Whirligig231/myrmidon/Docs/M_Machine_Spec.xlsx

CONTROL FLOW
Instruction |  |  |  | Assembly | Description | Notes
00 | 00 | 00 | 00 | nop | Nop
01 | 00 | xx | xx | end | End if / while / routine | The assembler marks a relative jump address. You must return before the end instruction
02 | xx | yy | yy | if xx | If register xx is nonzero | The assembler marks a relative jump address
03 | xx | yy | yy | while xx | While register xx is nonzero | The assembler marks a relative jump address
04 | 00 | xx | xx | else | Else | The assembler marks a relative jump address
05 | xx | 00 | 00 | switch xx | Jump a number of instructions ahead equal to register xx
06 | xx | yy | yy | gz xx NAME | Goto if register xx is zero | The label will be replaced by a relative jump in the assembler
07 | xx | yy | yy | gnz xx NAME | Goto if register xx is nonzero | The label will be replaced by a relative jump in the assembler
08 | xx | yy | yy | def NAME | Define routine (but do not run it) | The assembler marks a relative jump address
09 | xx | 00 | 00 | call NAME | Call routine and return here after
0a | 00 | xx | xx | goto NAME | Go to label NAME | The label will be replaced by a relative jump in the assembler
0b | 00 | xx | xx | break | Break while loop | The assembler marks a relative jump address
0c | 00 | xx | xx | continue | Continue while loop | The assembler marks a relative jump address
0d | 00 | 00 | 00 | return | Return from routine
0e | 00 | 00 | 00 | reset | Restart the system
0f | xx | 00 | 00 | print xx | Print the value of register xx, unsigned, over the serial connection | For debug use only
ARITHMETIC
Instruction |  |  |  | Assembly | Description | Notes
10 | xx | yy | zz | + xx yy zz | Set register xx to the sum of registers yy and zz
11 | xx | yy | zz | - xx yy zz | Set register xx to the difference of registers yy and zz | For negation, use - xx 0 yy
12 | xx | yy | zz | * xx yy zz | Set register xx to the product of registers yy and zz | Yes, this works both signed and unsigned, thanks to the magic of the ring Z/65536Z. Trust me, I have a math degree
13 | xx | yy | zz | / xx yy zz | Set register xx to the unsigned quotient of registers yy and zz | Division by zero is undefined behavior (I'm too lazy to implement exceptions)
14 | xx | yy | zz | s/ xx yy zz | Set register xx to the signed quotient of registers yy and zz
15 | xx | yy | zz | % xx yy zz | Set register xx to the unsigned modulus of registers yy and zz
16 | xx | yy | zz | s% xx yy zz | Set register xx to the signed modulus of registers yy and zz
17 | xx | yy | zz | frac xx yy zz | Set register xx to the fractional part of the unsigned quotient yy / zz | This sets xx to the first four digits of yy / zz after the decimal point in base 16. In other words, xx / 65536 ~= yy / zz
18 | xx | yy | zz | sfrac xx yy zz | Set register xx to the fractional part of the signed quotient yy / zz | The fractional part is computed using floor(), so e.g. the fractional part of -1.4 is +0.6. Output is unsigned
19 | xx | yy | zz | == xx yy zz | Set register xx to 1 if registers yy and zz are equal and 0 otherwise | For boolean NOT, use == xx yy 0
1a | xx | yy | zz | != xx yy zz | Set register xx to 1 if registers yy and zz are unequal and 0 otherwise
1b | xx | yy | zz | < xx yy zz | Set register xx to 1 if register yy is less than zz, unsigned, and 0 otherwise | For >, use < xx zz yy
1c | xx | yy | zz | s< xx yy zz | Set register xx to 1 if register yy is less than zz, signed, and 0 otherwise
1d | xx | yy | zz | <= xx yy zz | Set register xx to 1 if register yy is less than or equal to zz, signed, and 0 otherwise | For >=, use <= xx zz yy
1e | xx | yy | zz | s<= xx yy zz | Set register xx to 1 if register yy is less than or equal to zz, signed, and 0 otherwise
1f | xx | yy | zz | & xx yy zz | Set register xx to the bitwise AND of registers yy and zz
20 | xx | yy | zz | && xx yy zz | Set register xx to the boolean AND of registers yy and zz
21 | xx | yy | zz | | xx yy zz | Set register xx to the bitwise OR of registers yy and zz | For ||, using | will be sufficient for conditionals. If you really need ||, you can use != zz zz 0 afterwards
22 | xx | yy | zz | ^ xx yy zz | Set register xx to the bitwise XOR of registers yy and zz | For ~, use ^ xx yy -1
23 | xx | yy | zz | << xx yy zz | Set register xx to register yy shifted left register zz times | Here zz is unsigned
24 | xx | yy | zz | >> xx yy zz | Set register xx to register yy shifted right register zz times | Here zz is unsigned
25 | xx | yy | zz | ? xx yy zz | Set register xx to register zz, only if yy is zero | Pay attention to the order of operators here. This can be used with = to simulate the behavior of the ternary operator ?:
26 | xx | yy | zz | absgn xx yy zz | Set register xx to the absolute value of register zz and yy to its signum
27 | xx | yy | zz | sqrt xx yy zz | Set register xx to the integer part of the square root of register zz and yy to the fractional part | Fractional part format is as in frac; zz is unsigned
28 | xx | yy | zz | red xx yy zz | Set the register xx to register yy with the red part changed to register zz | Here zz should be from 0 to 255
29 | xx | yy | zz | green xx yy zz | Set the register xx to register yy with the green part changed to register zz | Note that the green part has double the resolution, 6 bits instead of 5; the scale on zz is still 0 to 255
2a | xx | yy | zz | blue xx yy zz | Set the register xx to register yy with the blue part changed to register zz | Here zz should be from 0 to 255
2b | xx | yy | zz | +c xx yy zz | Set register xx to the carry when registers yy and zz are added, unsigned | These carry operations are used to implement Q16.16 or Q32.0 arithmetic
2c | xx | yy | zz | -c xx yy zz | Set register xx to the carry when registers yy and zz are subtracted, unsigned | See above
2d | xx | yy | zz | *c xx yy zz | Set register xx to the carry when registers yy and zz are mutliplied, unsigned | See above
2e | xx | yy | zz | conc xx yy zz | Set register xx to the low byte of register yy times 256 plus the low byte of register zz
2f | xx | yy | 00 | high xx yy | Set register xx to the high byte of register yy | For the low byte, use conc xx 0 yy
LOADING AND STORING
Instruction |  |  |  | Assembly | Description | Notes
30 | xx | yy | 00 | = xx yy | Set register xx to register yy (copy yy to xx)
31 | xx | yy | yy | = xx yyyy | Set register xx to immediate yyyy
32 | xx | yy | 00 | load xx yy | Load word at pointer yy into register xx
33 | xx | yy | yy | load xx yyyy | Load word at address yyyy into register xx
34 | xx | yy | 00 | store xx yy | Store register xx into word at pointer yy | One of the few commands where the input comes before the output
35 | xx | yy | yy | store xx yyyy | Store register xx into word at address yyyy | One of the few commands where the input comes before the output
36 | 00 | xx | 00 | window xx | Set the "window" (upper half of register space) to start at pointer xx
37 | 00 | xx | xx | window xxxx | Set the "window" (upper half of register space) to start at address xxxx
38 | 00 | xx | 00 | skip xx | Clear the stack and skip to code at pointer xx
39 | 00 | xx | xx | skip xxxx | Clear the stack and skip to code at address xxxx
3a | 00 | xx | 00 | skim xx | Read all def instructions in page starting at pointer xx | This does not use the standard instruction pointer, so execution will return immediately. Control flow is ignored. Reading starts at *xx and continues to the end of the page
3b | 00 | xx | xx | skim xxxx | Read all def instructions in page starting at address xxxx | See above
40 | xx | yy | 00 | read xx yy | Read a page of ROM indexed by register xx and overwrite the page at pointer yy | One of the few commands where the input comes before the output
41 | xx | yy | yy | read xx yyyy | Read a page of ROM indexed by register xx and overwrite the page at address yyyy | One of the few commands where the input comes before the output
42 | xx | yy | 00 | write xx yy | Write the page at pointer yy into the ROM page indexed by register xx | This will silently fail if page xx is not write-enabled in the ROM
43 | xx | yy | yy | write xx yyyy | Write the page at address yyyy into the ROM page indexed by register xx | See above
44 | xx | 00 | 00 | readb xx | Read the background indexed by register xx in ROM
45 | xx | yy | 00 | reads xx yy | Read the spritesheet indexed by register xx in ROM into the spritesheet at pointer yy | One of the few commands where the input comes before the output
46 | xx | 00 | 00 | readp xx | Read the palette indexed by register xx in ROM
47 | xx | 00 | 00 | rex xx | Read a page of ROM indexed by register xx, overwrite the current code page, and execute it
GRAPHICS
Instruction |  |  |  | Assembly | Description | Notes
50 | 00 | 00 | 00 | refresh | Display the framebuffer on the screen | This is a time-consuming operation that should be done once per frame
51 | xx | 00 | 00 | clear xx | Clear the framebuffer with color given by register xx
52 | xx | 00 | 00 | dbg (xx) | Draw the background to the framebuffer, with the upper left coordinate from pixel xx | The low 8 bits of a register are the row number; the high 8 bits are the column number. For this command only, the background wraps at the edges
53 | xx | yy | 00 | dbg16 xx yy | Draw a 16x16 portion of the background at pixel xx to pixel yy
54 | xx | yy | 00 | dbg8 xx yy | Draw an 8x8 portion of the background at pixel xx to pixel yy
55 | xx | yy | 00 | dbg4 xx yy | Draw a 4x4 portion of the background at pixel xx to pixel yy
56 | xx | yy | zz | dbg xx yy zz | Draw a portion of the background at pixel xx with dimensions zz to pixel yy | Note the order of the arguments
57 | xx | 00 | 00 | dss xx | Draw the spritesheet given by pixel xx to the framebuffer | Use xx = 0x0000 for the first spritesheet or 0x0040 for the second spritesheet
58 | xx | yy | 00 | dss16 xx yy | Draw a 16x16 portion of a spritesheet at pixel xx to pixel yy | Use rows 0-63 for the first spritesheet and rows 64-127 for the second spritesheet
59 | xx | yy | 00 | dss8 xx yy | Draw an 8x8 portion of a spritesheet at pixel xx to pixel yy
5a | xx | yy | 00 | dss4 xx yy | Draw a 4x4 portion of a spritesheet at pixel xx to pixel yy
5b | xx | yy | zz | dss xx yy zz | Draw a portion of a spritesheet at pixel xx with dimensions zz to pixel yy | Note the order of the arguments
5c | xx | yy | 00 | dpx xx yy | Set pixel xx to color yy
5d | xx | yy | zz | dchar xx yy zz | Draw ASCII character zz from spritesheet xx to pixel yy | Spritesheet is 0 or 1. Characters in the font sheet should be 6x8
5e | xx | yy | zz | dstr xx yy zz | Draw string at pointer zz from spritesheet xx to pixel yy | String must be null-terminated. Character 0x7f is treated as nothing (i.e. skipped)
60 | 00 | xx | yy | clearp xx yy | Fill the palette with color xx with flags yy
61 | xx | yy | zz | setp xx yy zz | Set the color at index xx in the palette to color yy with flags zz | Note the order of the arguments. Here the index is a register value
62 | xx | yy | zz | getp xx yy zz | Get the color at index xx in the palette and set registers yy and zz to it | One of the few commands where the input comes before the output
63 | 00 | xx | 00 | setpoffs xx | Set the palette offset to register xx
64 | 00 | xx | xx | setpoffs xxxx | Set the palette offset to index xxxx
TIMING
Instruction |  |  |  | Assembly | Description
70 | xx | 00 | 00 | frame | Wait for the end of the current frame. The ms / frame is given by xx, or 33 if xx is zero
71 | 00 | xx | 00 | delay xx | Delay a number of milliseconds equal to register xx
72 | 00 | xx | xx | delay xxxx | Delay xxxx milliseconds
INPUT
Instruction |  |  |  | Assembly | Description
80 | xx | yy | 00 | button xx yy | Set register xx to 1 if the button indexed by register yy is being held and 0 otherwise
81 | xx | yy | yy | button xx yyyy | Set register xx to 1 if button yyyy is being held and 0 otherwise
82 | xx | yy | 00 | buttonp xx yy | Set register xx to 1 if the button indexed by register yy was just pressed and 0 otherwise
83 | xx | yy | yy | buttonp xx yyyy | Set register xx to 1 if button yyyy was just pressed and 0 otherwise
84 | xx | yy | 00 | buttonr xx yy | Set register xx to 1 if the button indexed by register yy was just released and 0 otherwise
85 | xx | yy | yy | buttonr xx yyyy | Set register xx to 1 if button yyyy was just released and 0 otherwise
COLLISION
Instruction |  |  |  | Assembly | Description
90 | 00 | xx | 00 | colflags xx | Set the collision flags to test for to register xx
91 | 00 | xx | xx | colflags xxxx | Set the collision flags to test for to immediate xxxx
92 | xx | 00 | 00 | col xx | Set register xx to whether any pixel in the flagbuffer has the test flags
93 | xx | yy | 00 | col16 xx yy | Set register xx to whether any pixel in a 16x16 area at pixel yy has the test flags
94 | xx | yy | 00 | col8 xx yy | Set register xx to whether any pixel in an 8x8 area at pixel yy has the test flags
95 | xx | yy | 00 | col4 xx yy | Set register xx to whether any pixel in a 4x4 area at pixel yy has the test flags
96 | xx | yy | zz | col xx yy zz | Set register xx to whether any pixel in an area at pixel yy with dimensions zz has the test flags
STRING PROCESSING
Instruction |  |  |  | Assembly | Description
a0 | xx | yy | 00 | itoa xx yy | Convert register xx (unsigned) to a string and store it in 4 words at pointer yy | One of the few commands where the input comes before the output
a1 | xx | yy | yy | itoa xx yyyy | Convert register xx (unsigned) to a string and store it in 4 words at address yyyy
a2 | xx | yy | 00 | sitoa xx yy | Convert register xx (signed) to a string and store it in 4 words at pointer yy
a3 | xx | yy | yy | sitoa xx yyyy | Convert register xx (signed) to a string and store it in 4 words at address yyyy
a4 | xx | yy | 00 | strw xx yy | Calculate the width of string at pointer yy and store it in register xx
a5 | xx | yy | 00 | strh xx yy | Calculate the height of string at pointer yy and store it in register xx
SOUND AND MUSIC
Instruction |  |  |  | Assembly | Description
b0 | 00 | xx | 00 | loadsnd xx | Load sound stored in the page at pointer xxxx, setting up the pattern list
b1 | 00 | xx | xx | loadsnd xxxx | Load sound stored in the page at address xxxx, setting up the pattern list
b2 | xx | yy | 00 | playsnd xx yy | Play the pattern indexed by register yy using the playhead given by register xx (0 or 1)
b3 | xx | yy | yy | playsnd xx yyyy | Play pattern yyyy using the playhead given by register xx (0 or 1)
b4 | xx | 00 | 00 | stopsnd xx | Stop the playhead given by register xx (0 or 1)
MISCELLANEOUS
Instruction |  |  |  | Assembly | Description
f0 | xx | yy | 00 | random xx yy | Set register xx to a random integer from 0 to (the value of register yy) - 1, inclusive
f1 | xx | yy | yy | random xx yyyy | Set register xx to a random integer from 0 to yyyy - 1, inclusive
