Whirligig231/myrmidon/Docs/Sound_Spec.xlsx

CONTROL FLOW
tt | 00 | 00 | Stop execution, stop sound, and disable the playhead
tt | 01 | xx | Set tempo. The number xx is the number of tenths of a millisecond per tick. So for e.g. 130 BPM and 36 ticks per beat, this should be 600000/(130*36) ~= 128.
tt | 02 | 00 | Do nothing (wait for the next time to elapse)
tt | 03 | xx | Pause for xx*256 extra ticks before the next command
tt | 04 | xx | Defines the start of pattern xx -- this will still be executed if encountered!
tt | 05 | 00 | Defines the end of a pattern; execution will jump back up the stack
tt | 06 | xx | Run pattern xx, then come back here
tt | 07 | xx | Jump to pattern xx (do not put it on the stack)
OSCILLATOR 1
tt | 10 | xx | Set oscillator 1 to note xx, or 128 for off
tt | 11 | xx | Set max amplitude of oscillator 1 to xx (max 255)
tt | 12 | xx | Set attack of oscillator 1 to xx ticks
tt | 13 | xx | Set decay of oscillator 1 to xx ticks
tt | 14 | xx | Set sustain of oscillator 1 to xx (max 255)
tt | 15 | xx | Set release of oscillator 1 to xx ticks
tt | 16 | xx | Set pitch slide of oscillator 1 to xx ticks
tt | 17 | xx | Add note xx to a chord on oscillator 1
tt | 18 | xx | Set chord note length of oscillator 1 to xx ticks
tt | 1a | xx | Set oscillator 1 to note xx, or 128 for off. This command will pitch shift instead of starting a new note
OSCILLATOR 2
tt | 20 | xx | Set oscillator 2 to note xx, or 128 for off
tt | 21 | xx | Set max amplitude of oscillator 2 to xx (max 255)
tt | 22 | xx | Set attack of oscillator 2 to xx ticks
tt | 23 | xx | Set decay of oscillator 2 to xx ticks
tt | 24 | xx | Set sustain of oscillator 2 to xx (max 255)
tt | 25 | xx | Set release of oscillator 2 to xx ticks
tt | 26 | xx | Set pitch slide of oscillator 2 to xx ticks
tt | 27 | xx | Add note xx to a chord on oscillator 2
tt | 28 | xx | Set chord note length of oscillator 2 to xx ticks
tt | 2a | xx | Set oscillator 2 to note xx, or 128 for off. This command will pitch shift instead of starting a new note
OSCILLATOR 3
tt | 30 | xx | Set oscillator 3 to note xx, or 128 for off
tt | 31 | xx | Set max amplitude of oscillator 3 to xx (max 255)
tt | 32 | xx | Set attack of oscillator 3 to xx ticks
tt | 33 | xx | Set decay of oscillator 3 to xx ticks
tt | 34 | xx | Set sustain of oscillator 3 to xx (max 255)
tt | 35 | xx | Set release of oscillator 3 to xx ticks
tt | 36 | xx | Set pitch slide of oscillator 3 to xx ticks
tt | 37 | xx | Add note xx to a chord on oscillator 3
tt | 38 | xx | Set chord note length of oscillator 3 to xx ticks
tt | 3a | xx | Set oscillator 3 to note xx, or 128 for off. This command will pitch shift instead of starting a new note
BASS OSCILLATOR
tt | 40 | xx | Set bass oscillator to note xx, or 128 for off
tt | 46 | xx | Set pitch slide of bass oscillator to xx ticks
tt | 47 | xx | Add note xx to a chord on bass oscillator
tt | 48 | xx | Set chord note length of bass oscillator to xx ticks
tt | 49 | xx | Set bass oscillator type: 0 for triangle, 1 for sawtooth
tt | 4a | xx | Set bass oscillator to note xx, or 128 for off. This command will pitch shift instead of starting a new note
DRUMS
tt | 50 | xx | Play drum xx
