Whirligig231/myrmidon/(commit log)

2020-01-13 Added documentation for M-Machine language
    [M_Machine_Spec.xlsx]
2020-01-13 Added documentation for the Myrmidon wiring
2020-02-03 Initial commit of v1.1 sound update, documentation to follow
    [M_Machine_Spec.xlsx, Sound_Spec.xlsx]
2020-02-06 Updated schematic diagram
2020-02-06 Fixed a formatting issue in schematic
